mysteriousCzrsX/bus_simulator/docs/title_page.pdf

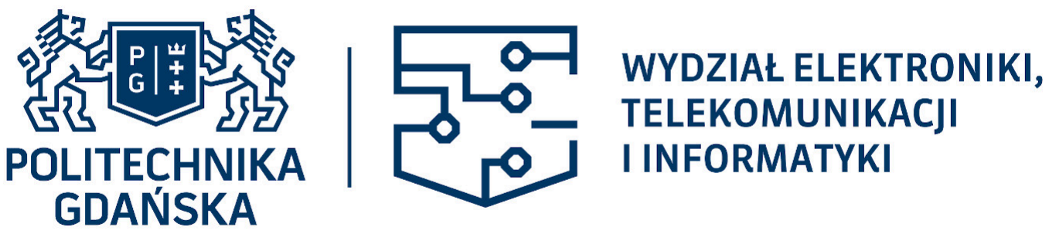
[picture p11: figure]

Imię i nazwisko studenta: Cezary Wieczorkowski Nr albumu: 188584
Poziom kształcenia: studia pierwszego stopnia Forma studiów: stacjonarne
Kierunek studiów: Elektronika i telekomunikacja Profil: Komputerowe systemy elektroniczne

### PRACA DYPLOMOWA INŻYNIERSKA

Tytuł pracy w języku polskim: Projekt i budowa laboratoryjnego stanowiska sterującego szyną danych

Tytuł pracy w języku angielskim: Design and construction of a laboratory data bus control station

Opiekun pracy: dr inż. Kamil Stawiarski
