mysteriousCzrsX/bus_simulator/hardware/bus_simulator/bus_simulator.kicad_pcb

## KiCad design hardware/bus_simulator/bus_simulator.kicad_pcb (2025-10-20)

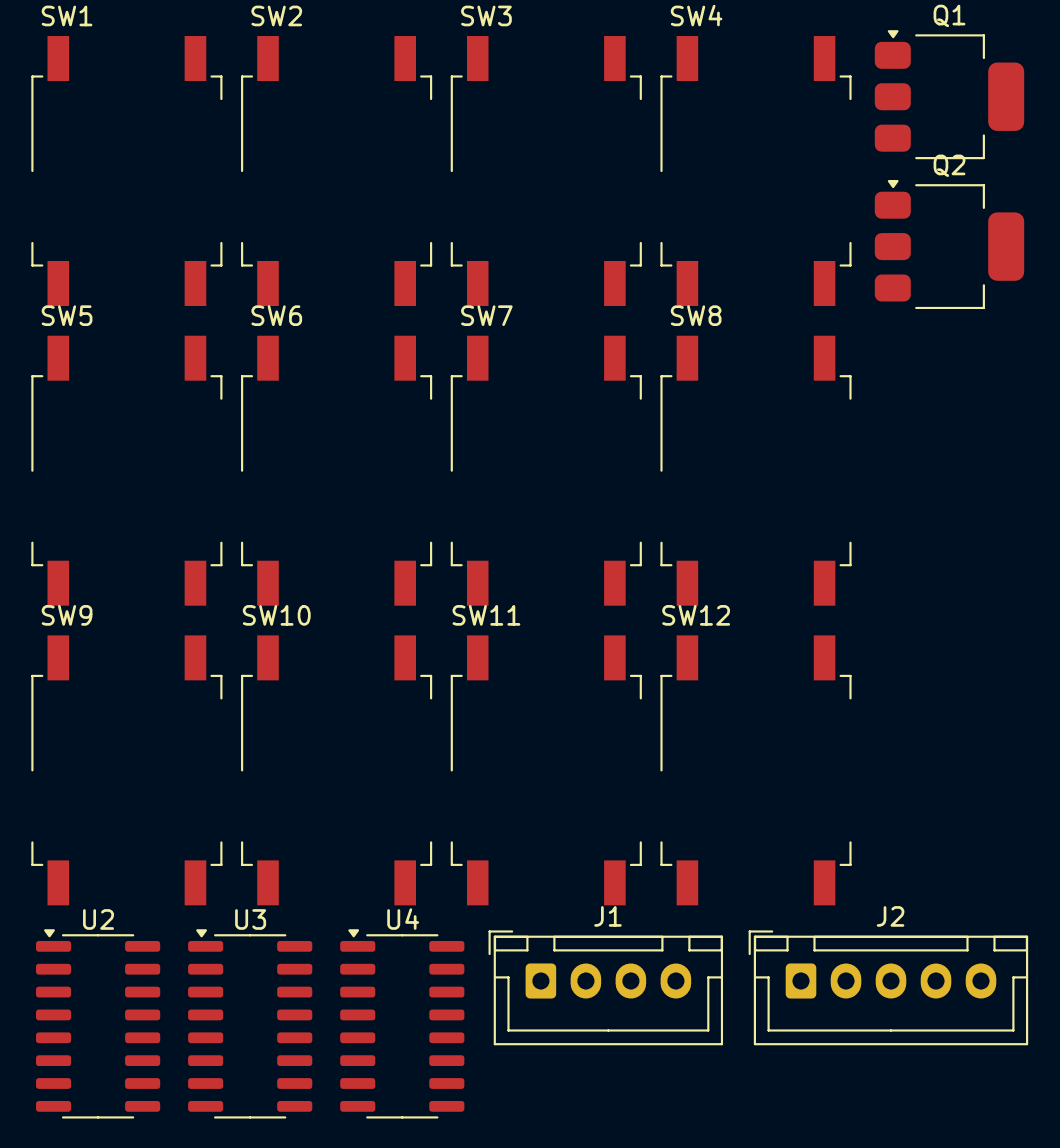
[picture p12: board bus_simulator.kicad_pcb from above]

Board: 2 copper layers, 19 parts (0 on the bottom side), 8 nets, no tracks yet.

Parts:
J1: I2C_LCD; JST_XH_B4B-XH-A_1x04_P2.50mm_Vertical
J2: Encoder; JST_XH_B5B-XH-A_1x05_P2.50mm_Vertical
Q1, Q2: BUK7880-55A; SOT-223-3_TabPin2
SW1, SW2, SW3, SW4, SW5, SW6, SW7, SW8, SW9, SW10, SW11, SW12: SW_Push; SW_MEC_5GSH9
U2, U3, U4: 74HC595; SOIC-16_3.9x9.9mm_P1.27mm

Connections:
+3.3V: J2.5, Q1.1 (G), Q2.1 (G), U2.10 (~SRCLR), U2.16 (VCC), U3.10 (~SRCLR), U3.16 (VCC), U4.10 (~SRCLR), U4.16 (VCC)
GND: J1.1, J2.1, SW1.1, SW2.1, SW3.1, SW4.1, SW5.1, SW6.1, SW7.1, SW8.1, SW9.1, SW10.1, SW11.1, SW12.1, U2.8 (GND), U2.13 (~OE), U3.8 (GND), U3.13 (~OE), U4.8 (GND), U4.13 (~OE)
unnamed: J1.3, Q1.2 (D)
unnamed: J1.4, Q2.2 (D)
unnamed: U2.11 (SRCLK), U3.11 (SRCLK), U4.11 (SRCLK)
unnamed: U2.12 (RCLK), U3.12 (RCLK), U4.12 (RCLK)
unnamed: U2.9 (QH'), U3.14 (SER)
unnamed: U3.9 (QH'), U4.14 (SER)
