mysteriousCzrsX/bus_simulator/(commit log)

2024-03-17 Added schematic
    [bus_simulator.kicad_sch]
2024-03-17 Finished schematic
    [bus_simulator.kicad_sch]
2024-03-22 Implemented alu operations
    [bus_simulator.kicad_sch]
2024-12-10 Changed led naming
    [bus_simulator.kicad_sch]
2025-01-08 Add voltage level converter
    [bus_simulator.kicad_sch]
2025-01-13 Fixed typos and removed old comments
    [bus_simulator.kicad_sch]
2025-10-20 Schematic fixes
    [bus_simulator.kicad_pcb, bus_simulator.kicad_sch]
